dsharp32/mars_regolith_rover/Design Journal/books.jpg

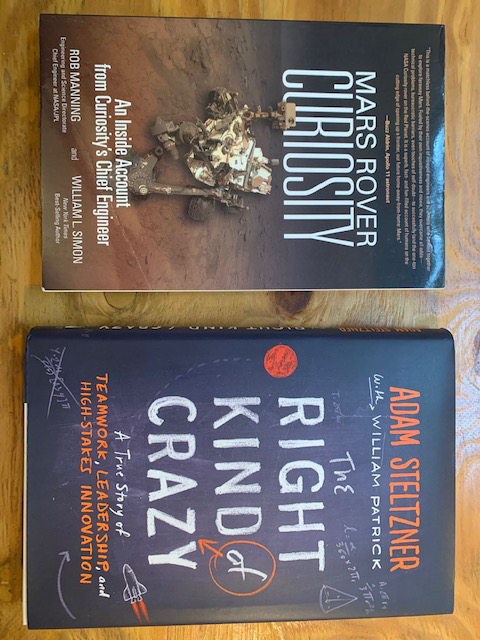
Design Journal/books.jpg
