dsharp32/mars_regolith_rover/pictures/cadc.png

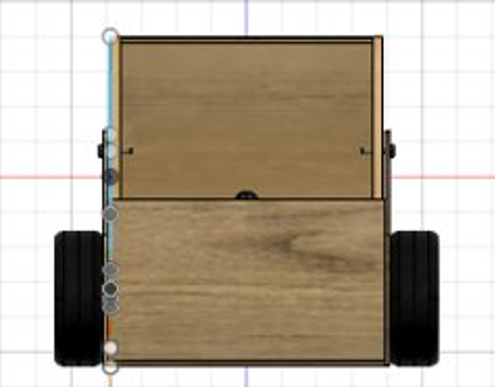
pictures/cadc.png
