dsharp32/mars_regolith_rover/Arduino Code/motor_pins.docx

// Set Right Motors to forward

//Right Back

digitalWrite(RB_in1, LOW);

digitalWrite(RB_in2, HIGH);

// set speed to 200 out of possible range 0~255

analogWrite(RB_enA, 255);

//Right Front

digitalWrite(RF_in3, HIGH);

digitalWrite(RF_in4, LOW);

// set speed to 200 out of possible range 0~255

analogWrite(RF_enB, 255);

// Set Left Motors to forward

//Left Front

digitalWrite(LF_in1, LOW);

digitalWrite(LF_in2, HIGH);

// set speed to 200 out of possible range 0~255

analogWrite(LF_enA, 255);

//Left Back

digitalWrite(LB_in3, HIGH);

digitalWrite(LB_in4, LOW);

// set speed to 200 out of possible range 0~255

analogWrite(LB_enB, 255);

delay(6000);

// Set Motors backwards

//Right Back

digitalWrite(RB_in1, HIGH);

digitalWrite(RB_in2, LOW);

// set speed to 200 out of possible range 0~255

analogWrite(RB_enA, 255);

//Right Front

digitalWrite(RF_in3, LOW);

digitalWrite(RF_in4, HIGH);

// set speed to 200 out of possible range 0~255

analogWrite(RF_enB, 255);

// Set Left Motors to forward

//Left Front

digitalWrite(LF_in1, HIGH);

digitalWrite(LF_in2, LOW);

// set speed to 200 out of possible range 0~255

analogWrite(LF_enA, 255);

//Left Back

digitalWrite(LB_in3, LOW);

digitalWrite(LB_in4, HIGH);

// set speed to 200 out of possible range 0~255

analogWrite(LB_enB, 255);
