dsharp32/mars_regolith_rover/EDP Group Presentation/ENGG1000_EDP.pptx

## Team 10 Design Presentation

## Importance of the Concept Generation Stage

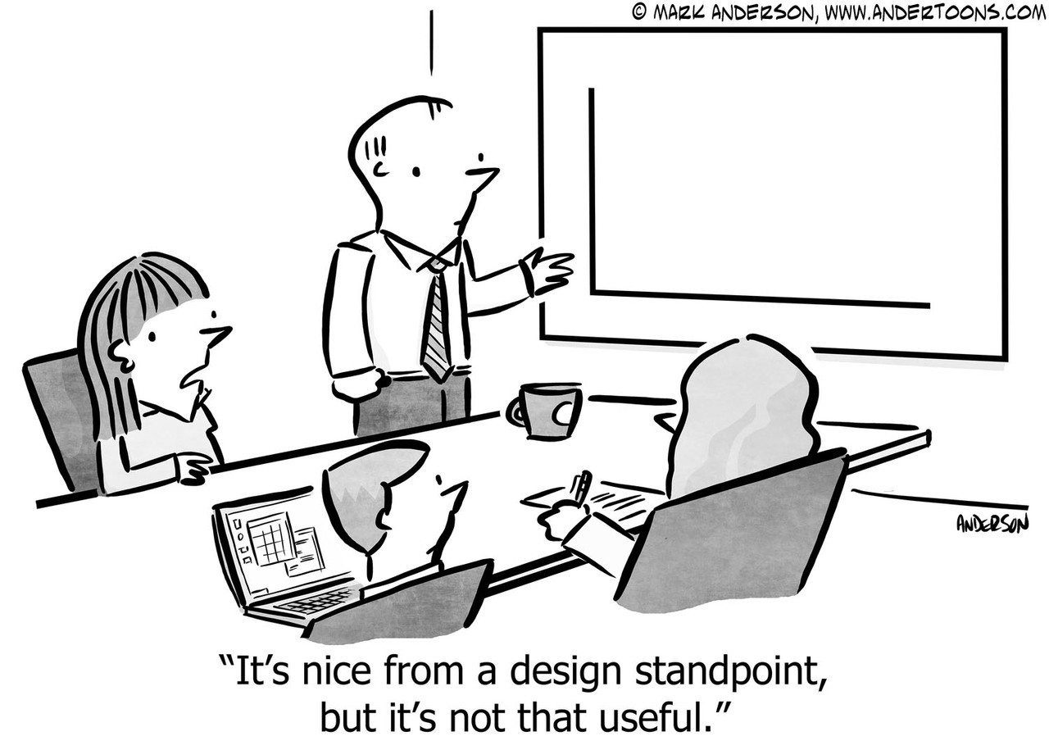
[picture p4: figure]

Notes: Every presentation should start with a joke..

Presentation schedule - problem statement, research, idea generation, morph chart, CAD design, build progress, future work and conclusion

## Project Goals

- Design and produce a rover prototype to collect regolith for 3d printing a radiation shelter.
- Required to operate in a Martian environment (think sand and rocks), no oxygen etc
- A high rate a of collection is better

- Produce a working prototype of a rover.
- The rover must be built in ten weeks.
- It must be able to move about on a Mars like surface and collect resources
- It must operate continuously and collect as much regolith as possible in 4 minutes.

Notes: Simplified problem statement - increase population of Mars!

## Slide 4

Research
- Talked to our mentor (previous champion!)
- Read books (technical and general)
- Looked at previous years designs

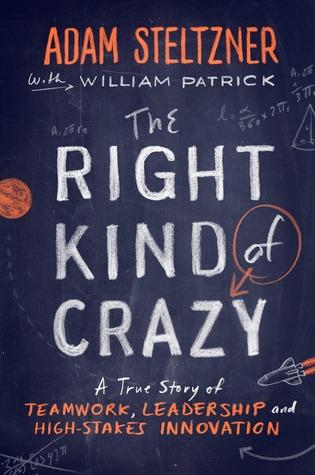
[picture p5: figure]

## Concept generation & sketches

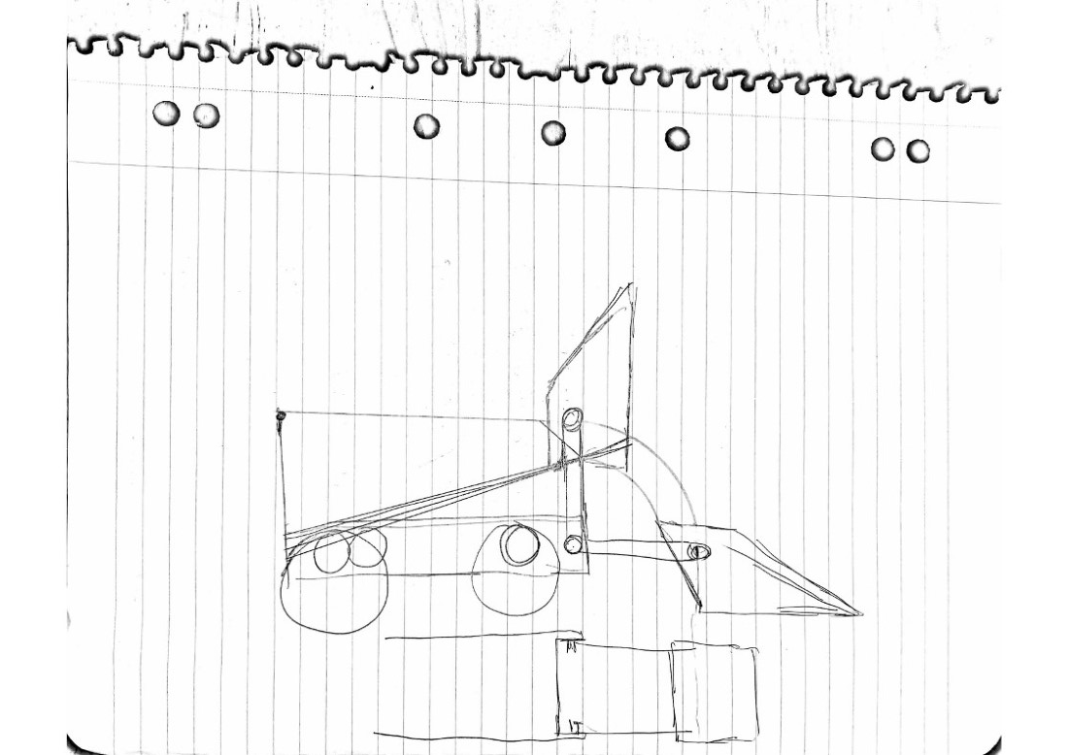
[picture p6: figure]

## Morph Chart and Analysis

- Focus on Simplicity
- Few parts - easy to take apart and maintain
- Plywood Construction
- 4 wheel drive with differential steering
- Radio controlled
- Arduino microprocessor
- Scoop for collection
- Gravity feed dispatching mechanism
- Designed to collect and carry 5kg of regolith

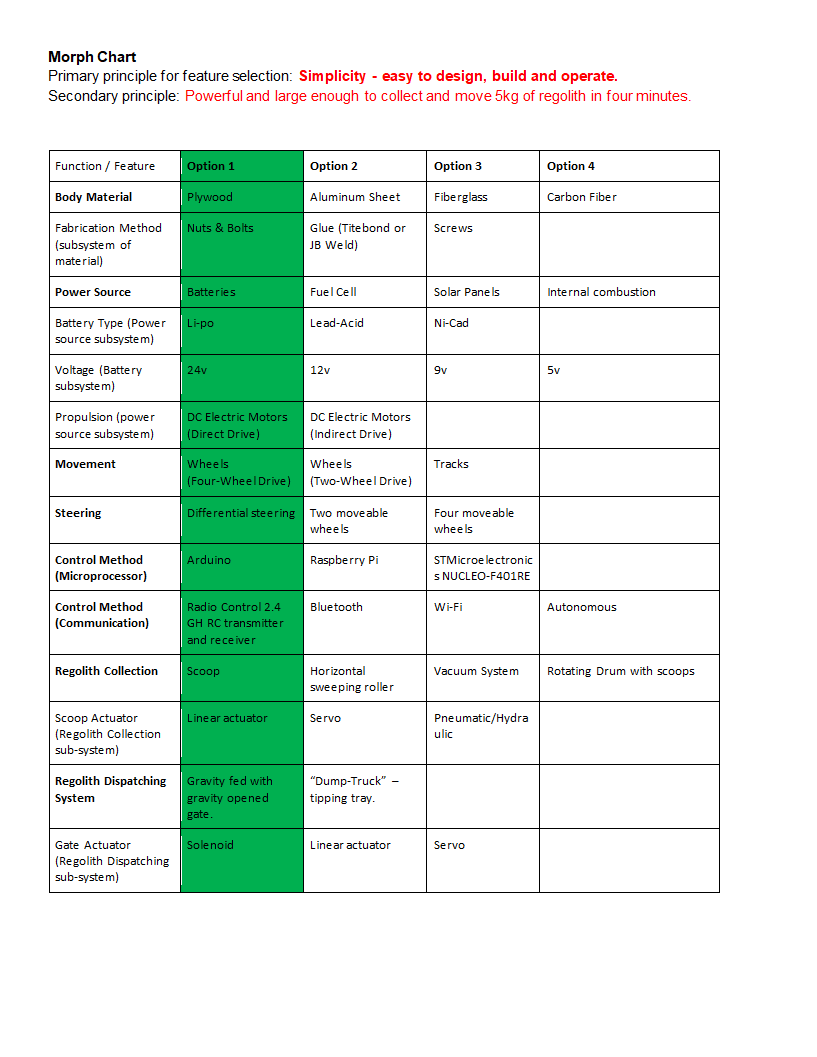
[picture p7: figure]

Notes: Simplified Morph chart - each design choice motivated by simplicity.

## CAD Design

- Designed in Fusion 360
- Profile sketches easily downloaded for laser cutting
- Made geometry of the Scoop easier to visualize and calculate
- Renders make communicating design to team and clients easier


## Slide 8

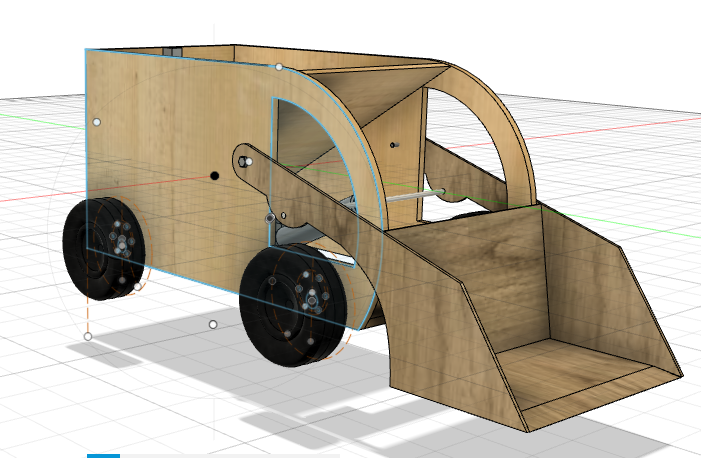
[picture p8: figure]

## Design Concept Prototype Light and strong with large capacity (5kg regolith) Powerful (24 Volt 4 wheel drive and 500N linear actuator) Easy to maintain and operate

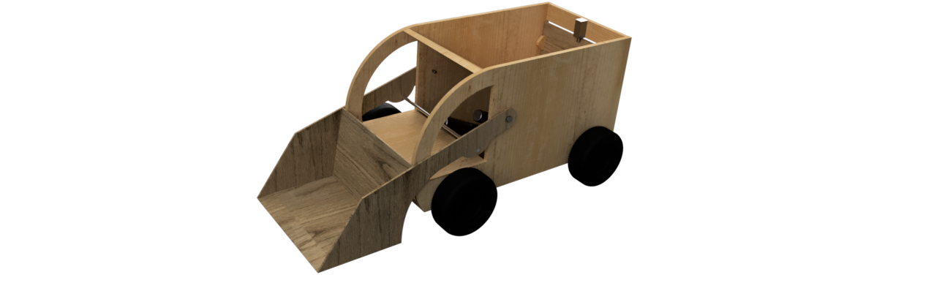
[picture p9: figure]

## Electronics & Control System

- Control system is 2.4 Gh RC transmitter and receiver
- Arduino Mega with 3x H-Bridge MOSFET Motor Controllers
- 128 bit rotary encoder for arm position
- RC servo to open dispatching gate
- Hall effect current sensor as fuse/ energy use measurement
- Code adapted from ‘Arduino Robotics’ (Warren et al. 2011)

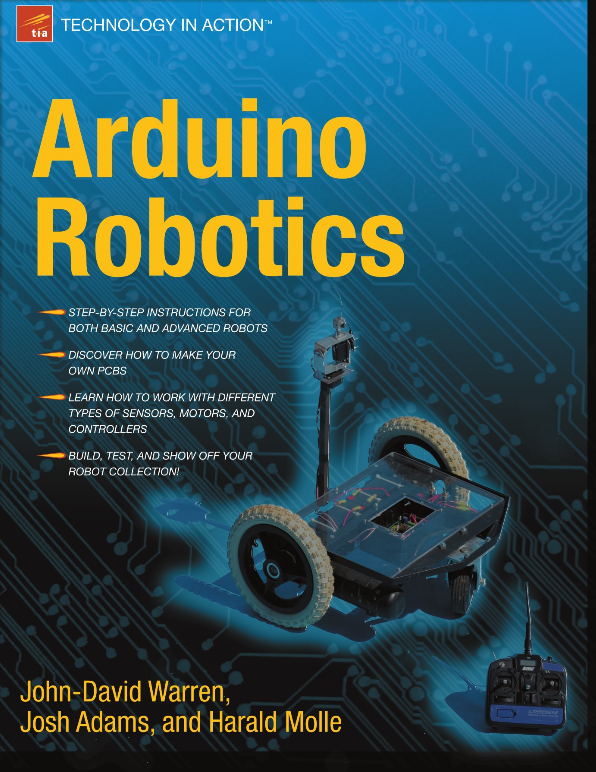
[picture p10: figure]

## Project update - April 2nd

- Body designed and assembled
- Electronics installed
- Waiting on receiver and wheel shafts
- Regolith collection and dispatch testing next week

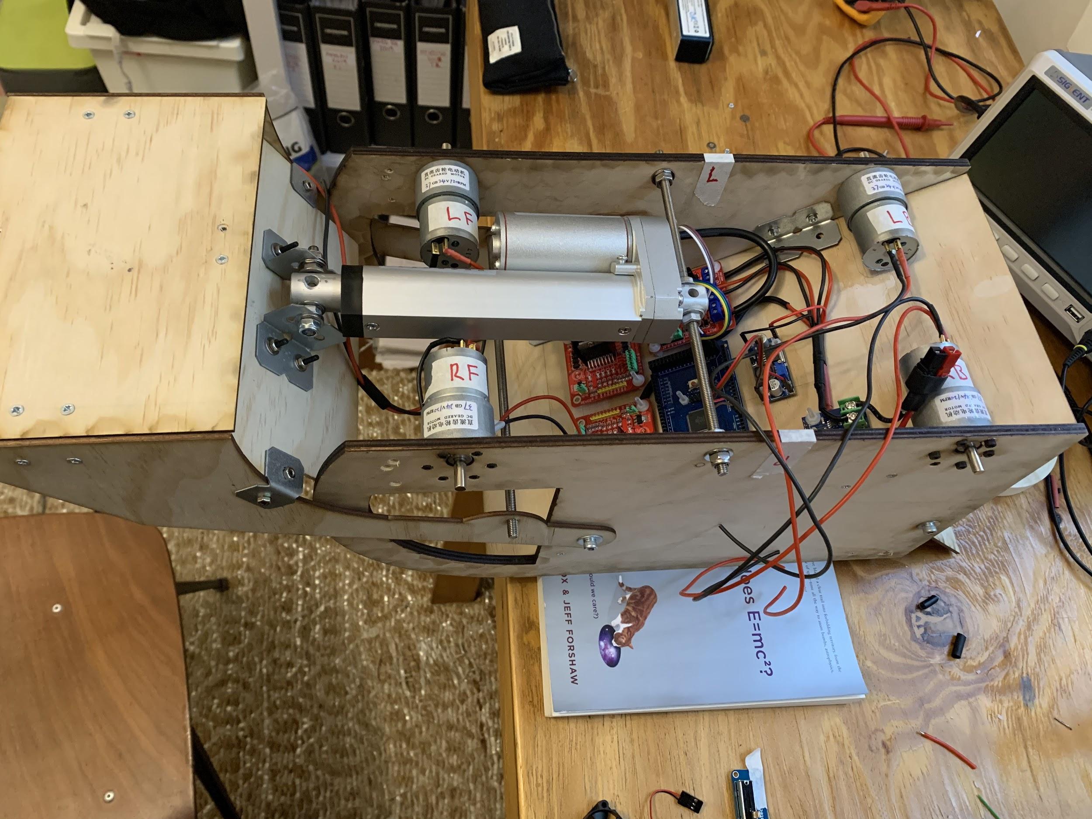
[picture p11: figure]

## Slide 12

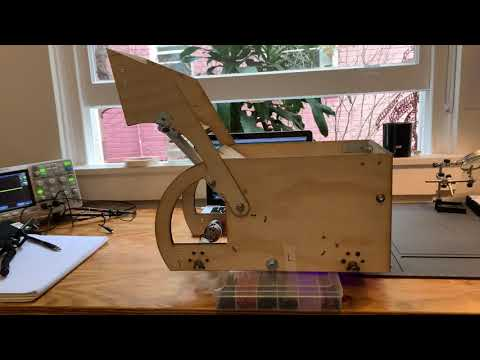
[picture p12: figure]
Regotron Scoop Test

Notes: Scoop test! Thanks for listening!
