dsharp32/mars_regolith_rover/Rover/motor_pins_rover.docx

// connect motor controller pins to Arduino digital pins

// Linear Actuator - A

int LIN_enB = 46;

int LIN_in3 = 50;

int LIN_in4 = 48;

// Left front - Motor - A

int LF_enA = 2;

int LF_in1 = 3;

int LF_in2 = 4;

// Left Back- Motor B

int LB_in3 = 5;

int LB_in4 = 6;

int LB_enB = 7;

// Right Front- Motor B

int RF_enB = 8;

int RF_in4 = 9;

int RF_in3 = 10;

// Right Back - Motor A

int RB_in2 = 11;

int RB_in1 = 12;

int RB_enA = 13;
