dsharp32/mars_regolith_rover/Rover/Rover_Arduino_MOTOR_PINS.docx

// connect motor controller pins to Arduino digital pins

// Linear Actuator

int LIN_enA = 39;

int LIN_in1 = 37;

int LIN_in2 = 35;

// Right Back - Motor A

int RB_enA = 22;

int RB_in1 = 24;

int RB_in2 = 26;

// Right Front- Motor B

int RF_enB = 32;

int RF_in3 = 28;

int RF_in4 = 30;

// Left Back - Motor B

int LB_enA = 33;

int LB_in1 = 31;

int LB_in2 = 29;

// Left Front- Motor A

int LF_enB = 23;

int LF_in3 = 27;

int LF_in4 = 25;
