dsharp32/mars_regolith_rover/Rover/serial_plotter_code.docx

int analogPin = A0; // linear Hall analog interface

int analogVal; // analog readings

void setup ()

{

pinMode(analogPin, INPUT);

Serial.begin(9600);

}

void loop ()

{

// Read the analog interface

analogVal = analogRead(analogPin);

Serial.println(analogVal); // print analog value

delay(100);

}
