dsharp32/mars_regolith_rover/Rover/Team Assessment.docx

Team Assessment

Explain why concept generation is important.

Create Morph chart – make sketches

Discuss ideas in group.

Put in where we are currently at in design/build
