dsharp32/mars_regolith_rover/Rover/BTS7960_Schematic.docx

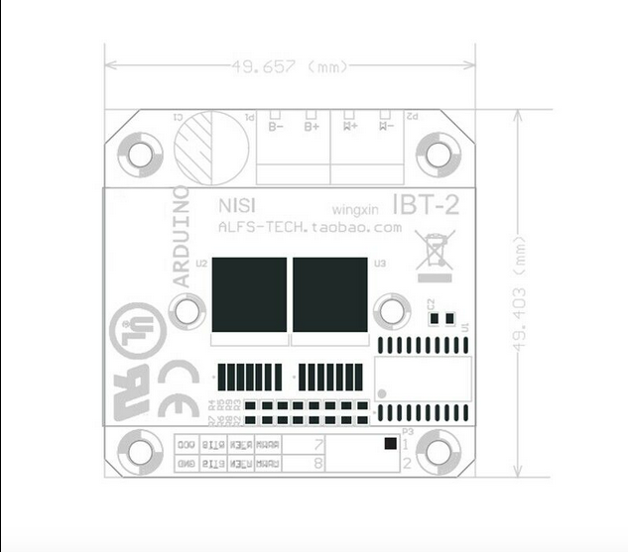
[picture p43: figure]
