dsharp32/mars_regolith_rover/Rover/Books.docx

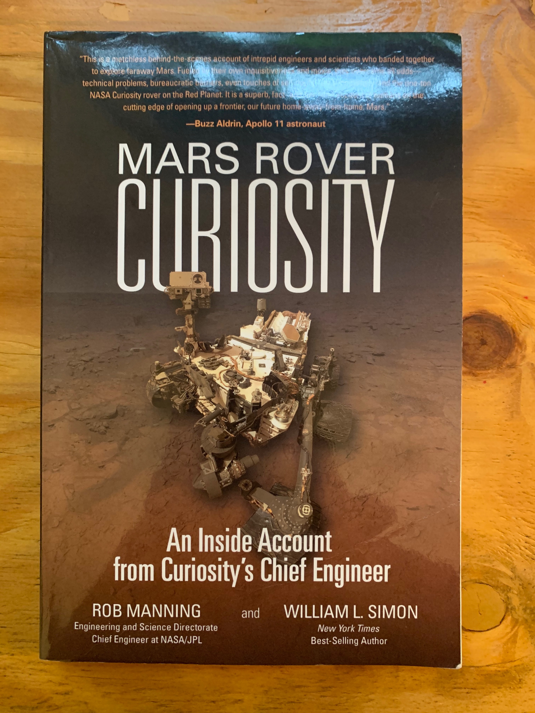
[picture p44: figure]
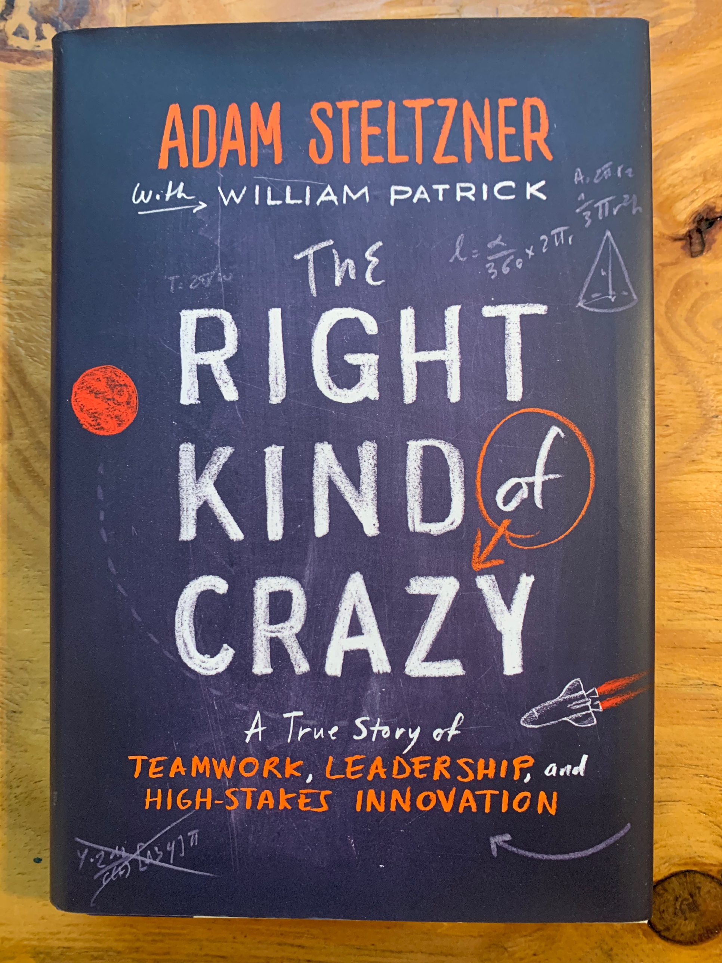
[picture p45: figure]
