dsharp32/mars_regolith_rover/Testing/rover_specifications.xlsx

Dimensions | Length [cm] | Width [cm] | Height[cm]
Scoop Lowered | 55 | 27.5 | 23
Scoop Raised | 47 | 27.5 | 40
Weight [kg] | 4.3
Maximum Load [kg] | 5.8
Maximum Speed [km/h] | 1.94
Collection Rate [kg/h] | 32.5
Energy Use [Wh] | 41.8
