dsharp32/mars_regolith_rover/pictures/cada.jpg

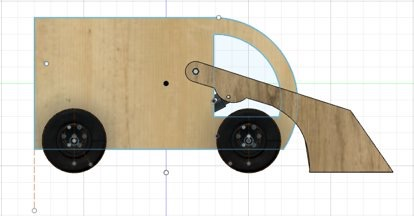
pictures/cada.jpg
