dsharp32/mars_regolith_rover/pictures/cadb.jpg

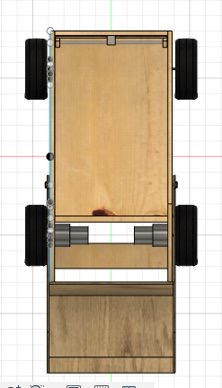
pictures/cadb.jpg
