dsharp32/mars_regolith_rover/pictures/Picture 1.jpg

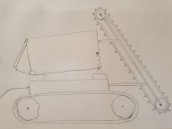
pictures/Picture 1.jpg
