dsharp32/mars_regolith_rover/pictures/Picture 2.jpg

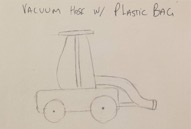
pictures/Picture 2.jpg
