dsharp32/mars_regolith_rover/pictures/Picture 3.png

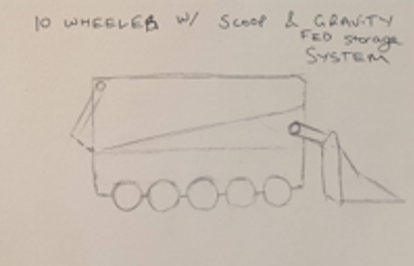
pictures/Picture 3.png
