dsharp32/mars_regolith_rover/pictures/Picture 4.png

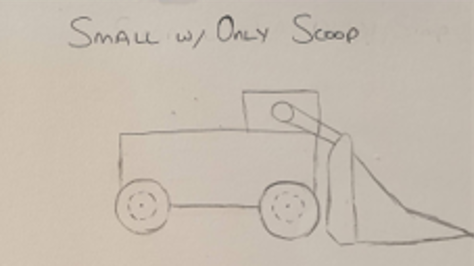
pictures/Picture 4.png
