dsharp32/mars_regolith_rover/pictures/Picture 5.png

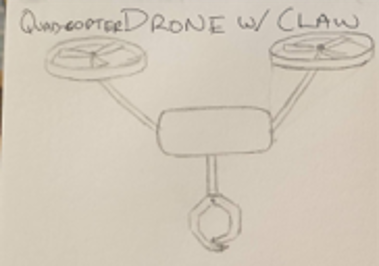
pictures/Picture 5.png
