dsharp32/mars_regolith_rover/Rover/Draft_V2_2020-Mar-19_04-42-36AM-000_CustomizedView4141925993_png_alpha.png

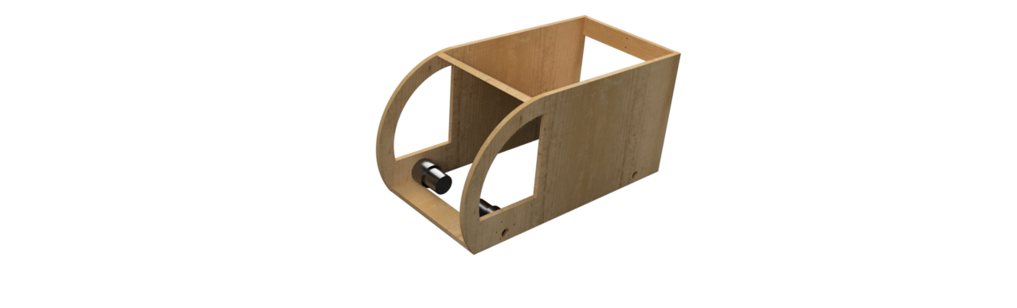
Rover/Draft_V2_2020-Mar-19_04-42-36AM-000_CustomizedView4141925993_png_alpha.png
