dsharp32/mars_regolith_rover/Rover/DRe8PbEWkAApa1v.jpg

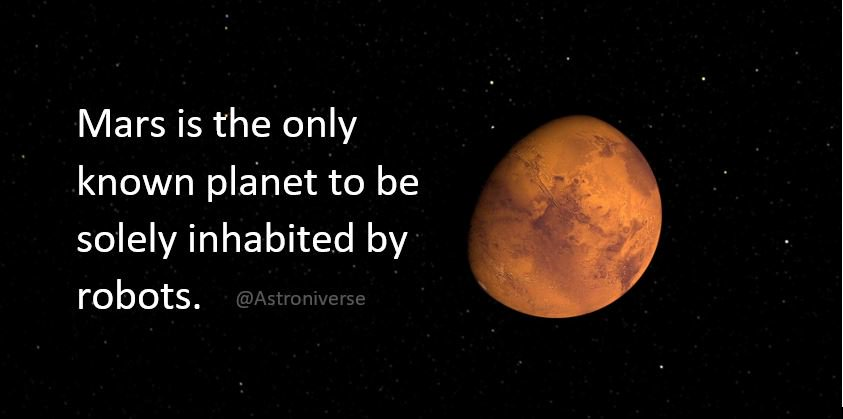
Rover/DRe8PbEWkAApa1v.jpg
