dsharp32/mars_regolith_rover/Rover/IMG_1760.jpg

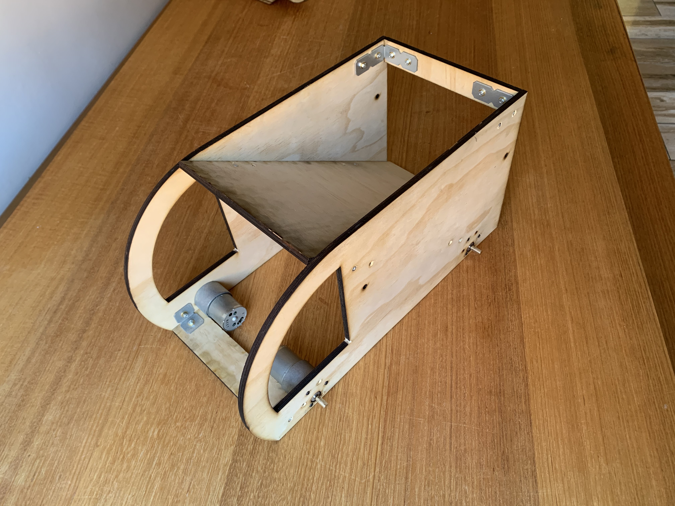
Rover/IMG_1760.jpg
