dsharp32/mars_regolith_rover/Rover/IMG_1822.jpg

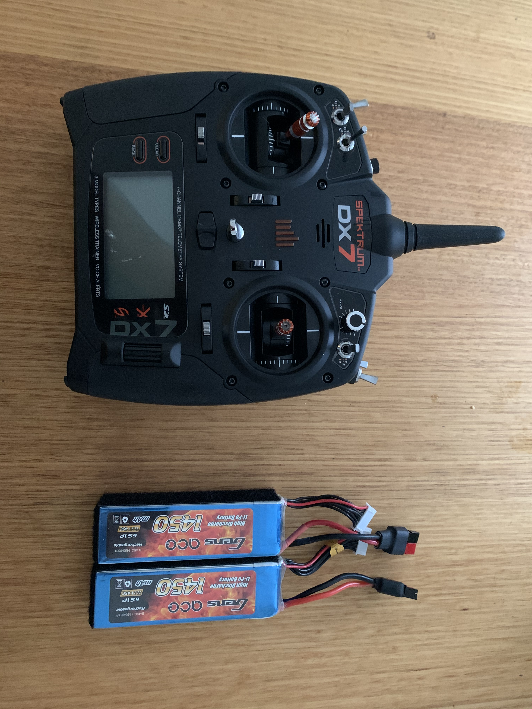
Rover/IMG_1822.jpg
