dsharp32/mars_regolith_rover/Rover/Rover_Presentation_Draft_V2_2020-Mar-19_03-32-50AM-000_CustomizedView21052464668_png.png

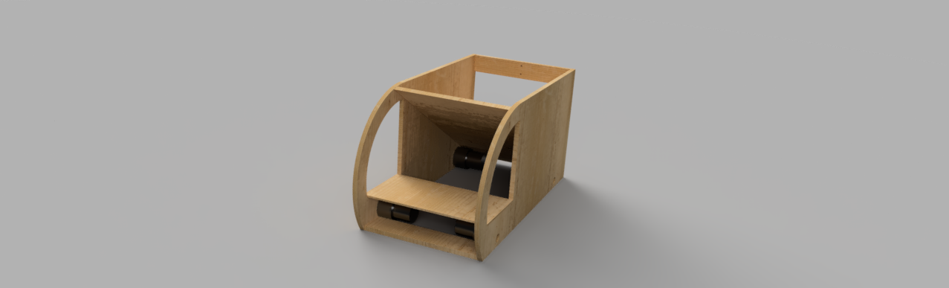
Rover/Rover_Presentation_Draft_V2_2020-Mar-19_03-32-50AM-000_CustomizedView21052464668_png.png
