dsharp32/mars_regolith_rover/Rover/s-l500.jpg

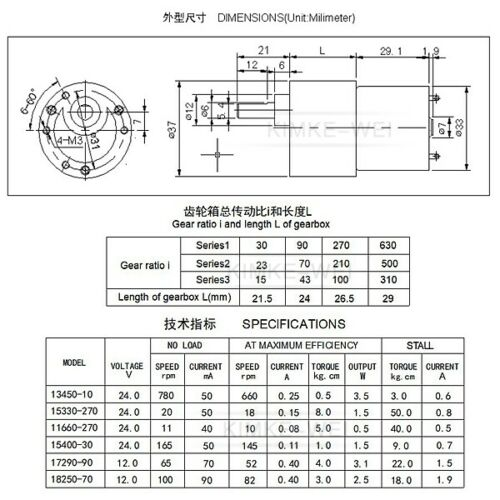
Rover/s-l500.jpg
