dsharp32/mars_regolith_rover/Rover/Screen Shot 2020-03-12 at 12.49.16 am.png

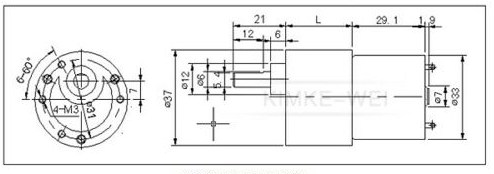
Rover/Screen Shot 2020-03-12 at 12.49.16 am.png
