dsharp32/mars_regolith_rover/Rover/View recent photos.png

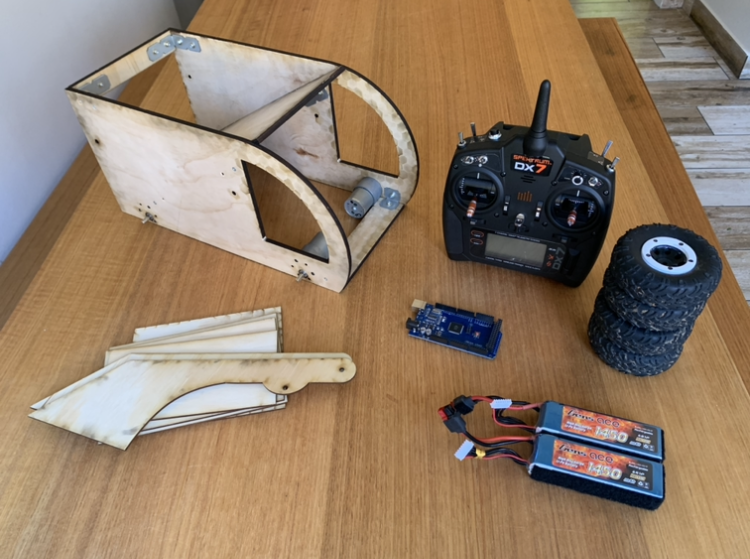
Rover/View recent photos.png
