dsharp32/mars_regolith_rover/Purchasing List/Purchasing_list.xlsx

Component List
No | Description | Required Quantity | Vendor | Purchase Quantity | Unit Price | Price | Website link
Main Components
1 | Interior Plywood Sheet 897mm*600mm*7mm | 1 | Bunnings | 1 | $14.00 | $14.00
2 | Interior Plywood Sheet 1200mm*810mm*3mm | 1 | Bunnings | 1 | $29.00 | $29.00
3 | Threaded Stainless Steel Rod 1200mm*6mm | 1 | Bunnings | 1 | $7.70 | $7.70
4 | Angle Bracket 25mm*25mm*40mm | 3 | Bunnings | 3 | $4.60 | $13.80
5 | M5*35mm Machine Bolt | 3 | Bunnings | 3 | $3.35 | $10.05
6 | M5 Flat Washer 35Pk | 1 | Bunnings | 2 | $4.60 | $9.20
7 | M5 Hexagon Nut 20Pk | 1 | Bunnings | 3 | $3.35 | $10.05
8 | M6 Nylon Lock Nut 6pk | 2 | Bunnings | 2 | $3.35 | $6.70
9 | M6 Nylon Stainless Steel Nut 6pk | 2 | Bunnings | 2 | $3.35 | $6.70
10 | M3*15 mm Machine Bolt | 3 | Bunnings | 3 | $3.35 | $10.05
11 | M3 Flat Washer 35Pk | 1 | Bunnings | 2 | $4.60 | $9.20
12 | M3 Hexagon Nut 200Pk | 1 | Jaycar | 1 | $9.95 | $9.95
13 | Threaded Stainless Steel Rod 1200mm*8mm | 1 | Bunnings | 1 | $7.70 | $7.70
14 | Coreflute | 1 | Bunnings | 1
15
Electronic Components
16 | MEGA 2560 R3 Arduino komp. Mikrokontroller Board Atmel ATmega2560 CH340G | 1 | eBay | 1 | 19.50 | 19.50
17 | 37mm 12V/24V DC 5RPM - 1000RPM High Torque Gear Box Motor Reducer Reversible New | 4 | eBay | 4 | 19.69 | 78.76
18 | Module DC-DC Volt Regulator Arduino Comp | 1 | Jaycar | 1 | 7.95 | 7.95
19 | DC12/24V 20mm-500mm Multi-function Linear Actuator Motor Stroke Heavy Duty xN | 1 | eBay | 1 | 57.58 | 57.58
20 | Spektrum AR6210 2.4G 6CH Receiver | 1 | Secondhand | 1 | 40.00 | 40.00
21 | Arduino Compatible Stepper Motor Controller Module | 3 | Jaycar | 3 | 14.95 | 44.85
22 | Arduino Compatible 5A Current Sensor Module | 1 | Jaycar | 1 | 9.95 | 9.95
23 | Hookup wire
24 | Mini Brass Spade Connector 100Pk | 1 | Jaycar | 1 | $11.95 | $11.95
25
26
27
 |  |  |  |  | Total: | 414.64 | AUD
Other Potential Components/Tools
33
34
35
36
37
40
