dsharp32/mars_regolith_rover/Rover/Main_Body_Rover.dxf

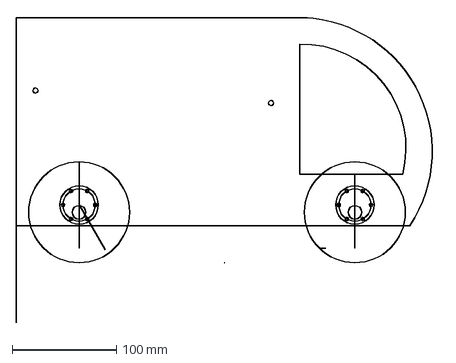
[picture p62: CAD file, 2020-05-26]
Rover/Main_Body_Rover.dxf
407.2 x 294.6 mm
