dsharp32/mars_regolith_rover/Rover/Rear_Gate_Rover.dxf

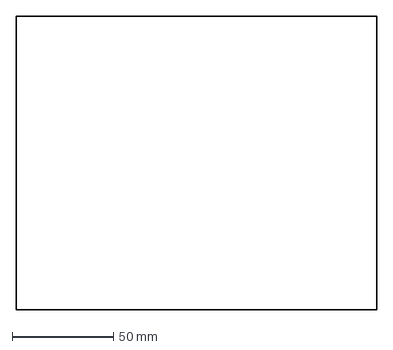
[picture p63: CAD file, 2020-05-26]
Rover/Rear_Gate_Rover.dxf
178.0 x 145.0 mm
