dsharp32/mars_regolith_rover/Rover/Front_Brace_Rover.dxf

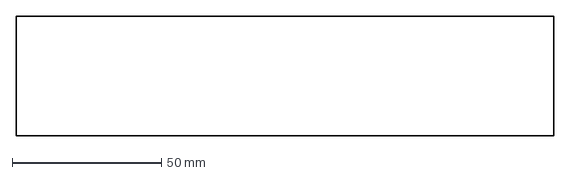
[picture p64: CAD file, 2020-05-26]
Rover/Front_Brace_Rover.dxf
180.0 x 40.0 mm
