dsharp32/mars_regolith_rover/Rover/Scoop_Floor_Rover.dxf

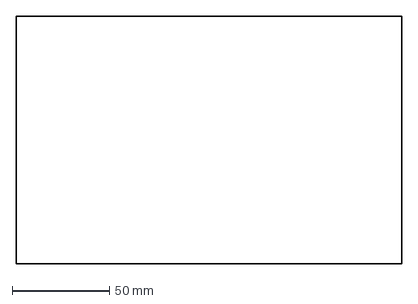
[picture p65: CAD file, 2020-05-26]
Rover/Scoop_Floor_Rover.dxf
198.0 x 127.0 mm
