dsharp32/mars_regolith_rover/Rover/Solenoid_Support_Rover.dxf

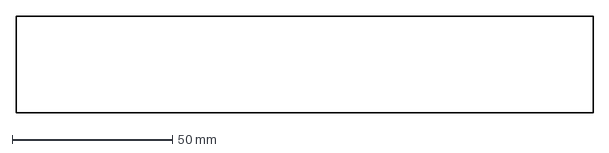
[picture p66: CAD file, 2020-05-26]
Rover/Solenoid_Support_Rover.dxf
180.0 x 30.0 mm
