dsharp32/mars_regolith_rover/Rover/Regolith_Tray_Rover.dxf

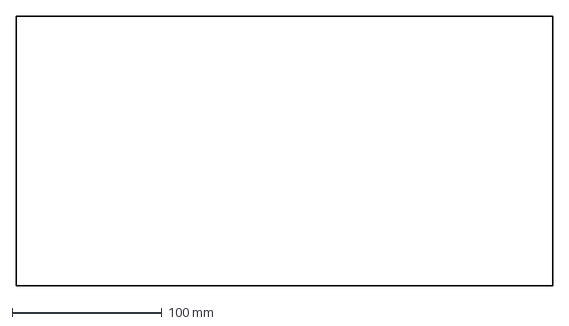
[picture p67: CAD file, 2020-05-26]
Rover/Regolith_Tray_Rover.dxf
358.0 x 180.0 mm
