dsharp32/mars_regolith_rover/Rover/Scoop_Rover.dxf

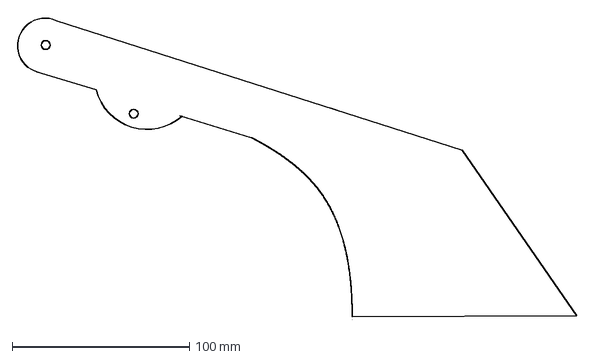
[picture p68: CAD file, 2020-05-26]
Rover/Scoop_Rover.dxf
316.5 x 171.2 mm
