dsharp32/mars_regolith_rover/Rover/Scoop_Back_Rover.dxf

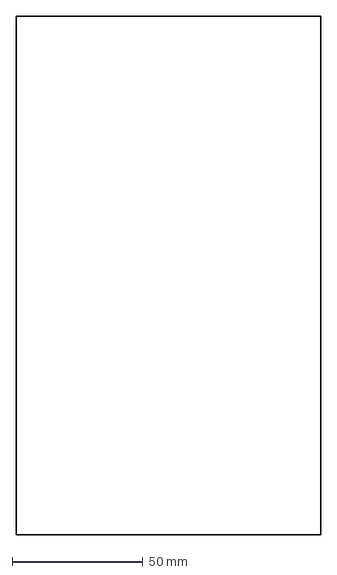
[picture p69: CAD file, 2020-05-26]
Rover/Scoop_Back_Rover.dxf
116.5 x 198.0 mm
