dsharp32/mars_regolith_rover/Rover/Arduino_Tray_Rover.dxf

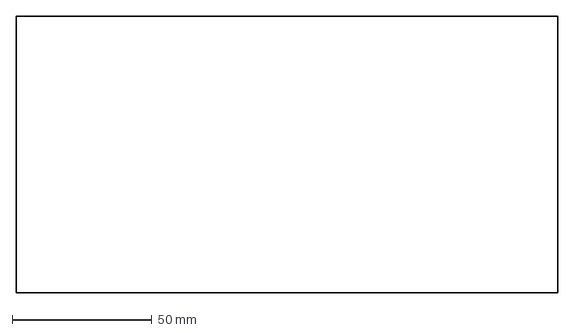
[picture p70: CAD file, 2020-05-26]
Rover/Arduino_Tray_Rover.dxf
193.7 x 99.0 mm
