dsharp32/mars_regolith_rover/Rover/Mechanical Build March 16th – 20th.pdf

# Mechanical Build March 16th – 20th

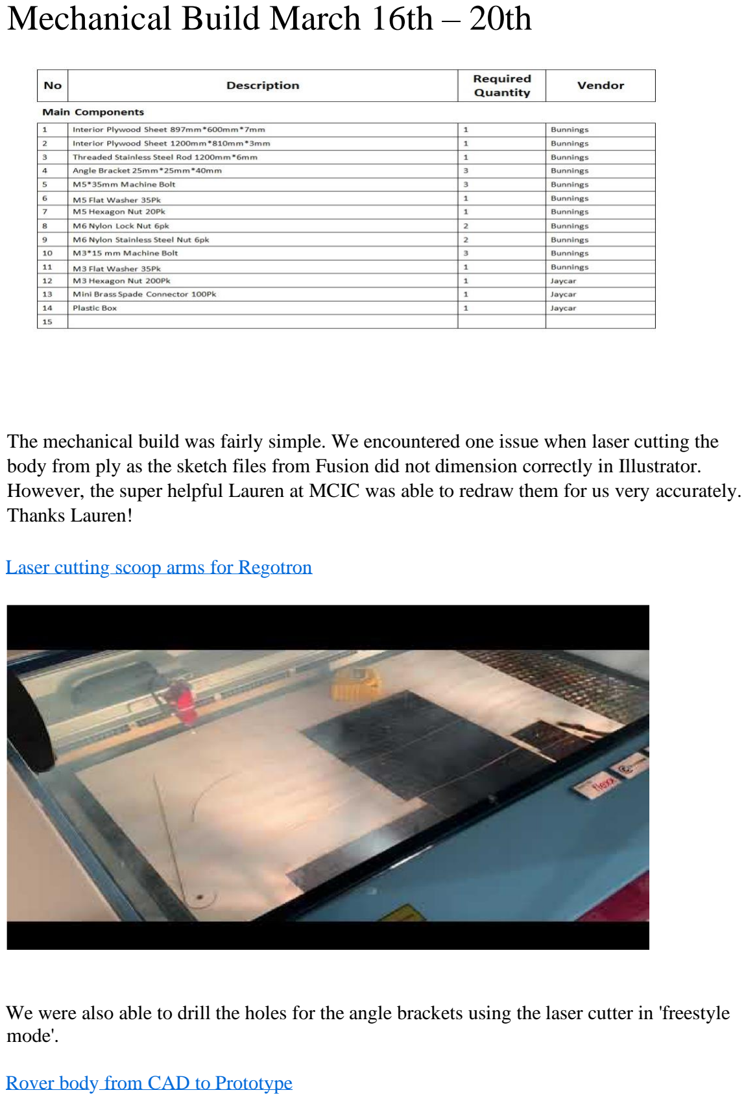
[picture p71: page 1]

The mechanical build was fairly simple. We encountered one issue when laser cutting the body from ply as the sketch files from Fusion did not dimension correctly in Illustrator. However, the super helpful Lauren at MCIC was able to redraw them for us very accurately. Thanks Lauren!

Laser cuttin (https://youtu.be/MvdhVEoitDo)g (https://youtu.be/MvdhVEoitDo) scoop arms for Re (https://youtu.be/MvdhVEoitDo)g (https://youtu.be/MvdhVEoitDo)otron (https://youtu.be/MvdhVEoitDo)

We were also able to drill the holes for the angle brackets using the laser cutter in 'freestyle mode'.

Rover bod (https://youtu.be/zkt2rj4I97I)y (https://youtu.be/zkt2rj4I97I) from CAD to Prototype (https://youtu.be/zkt2rj4I97I)

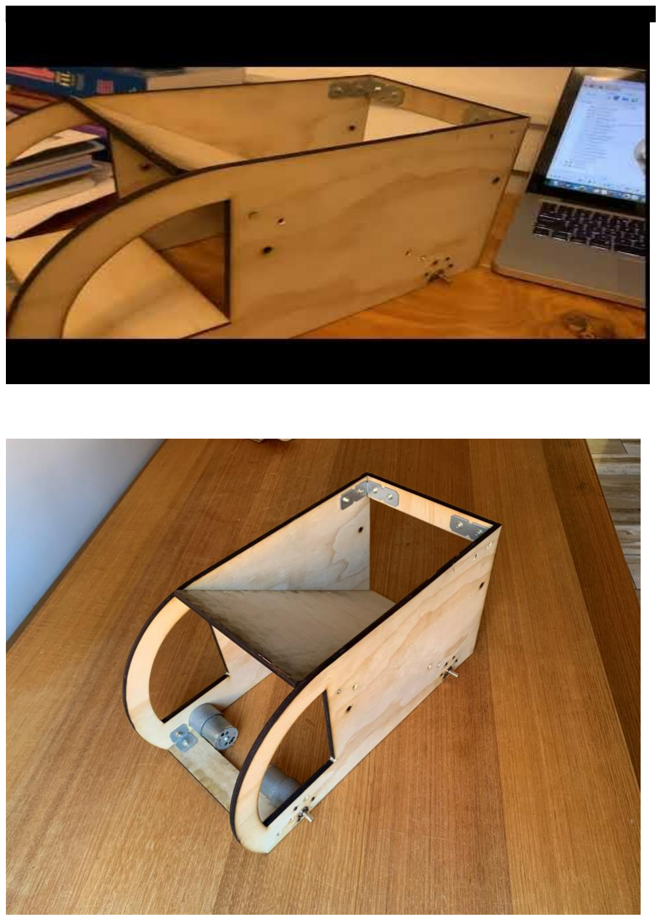
[picture p72: page 2]
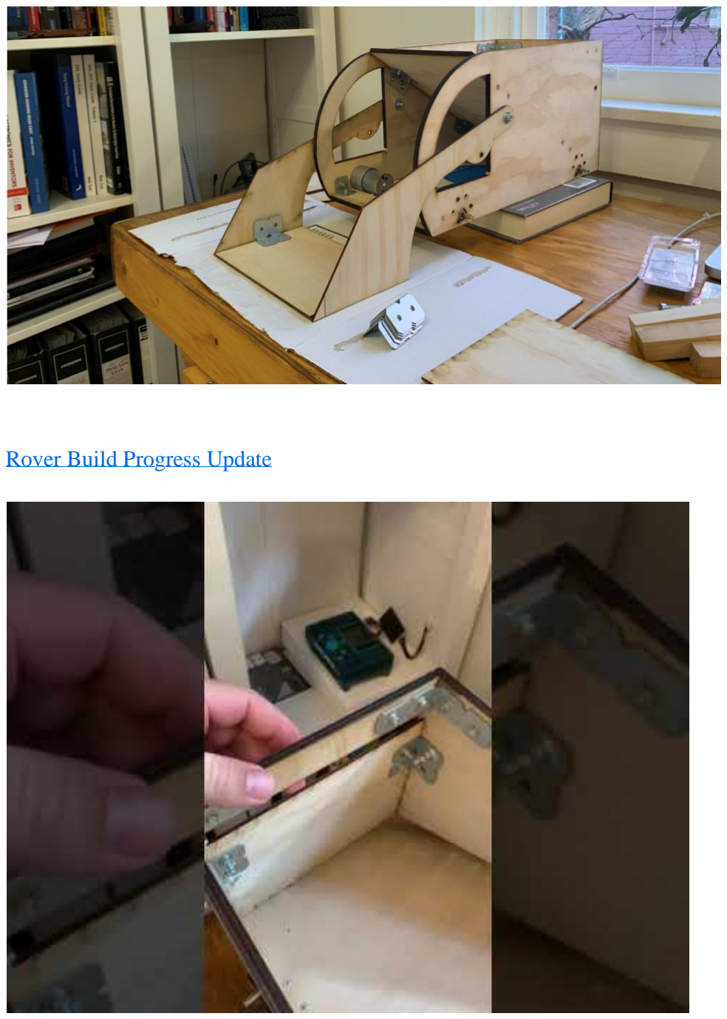
[picture p73: page 3]

Rover Build Pro (https://youtu.be/pcVCasUEwuk)g (https://youtu.be/pcVCasUEwuk)ress Update (https://youtu.be/pcVCasUEwuk)
