dsharp32/mars_regolith_rover/Testing/regolith_collection_test.xlsx

Test One
Date: 20/4/20 | Time (s) | Regolith Collected (g) | Energy Use (mAh)
Battery One | 240 | 2155.7 | 113.00
Test Two
Date: 20/4/20 | Time (s) | Regolith Collected (g) | Energy Use (mAh)
Battery Two | 240 | 2177 | 109.00
