dsharp32/mars_regolith_rover/Testing/speed_test.xlsx

Test One (Empty)
Battery No. | run 1 | run 2 | run 3 | run 4 | run 5
Time 1(s):
Time 2(s):
Run Distance (m) | 5 | 5 | 5 | 5 | 5
Total distance (m) | 10 | 10 | 10 | 10 | 10
Test Two (1 kg load)
Battery No. | run 1 | run 2 | run 3 | run 4 | run 5
Time 1(s):
Time 2(s):
Run Distance (m) | 5 | 5 | 5 | 5 | 5
Total distance (m) | 10 | 10 | 10 | 10 | 10
