dsharp32/mars_regolith_rover/Testing/rover_speed_test.xlsx

Test One (Empty)
Date: | run 1 | run 2 | run 3 | run 4 | run 5
Time 1(s): | 9.48 | 9.63 | 9.88 | 9.44 | 9.76
Time 2(s): | 9.01 | 8.74 | 8.53 | 8.39 | 8.86
Run Distance (m) | 5 | 5 | 5 | 5 | 5
Total distance (m) | 10 | 10 | 10 | 10 | 10
mAh: | 73
Test Two (1 kg load)
Date: | run 1 | run 2 | run 3 | run 4 | run 5
Time 1(s): | 9.71 | 9.66 | 10.16 | 10.06 | 9.80
Time 2(s): | 8.55 | 8.72 | 8.75 | 8.63 | 8.75
Run Distance (m) | 5 | 5 | 5 | 5 | 5
Total distance (m) | 10 | 10 | 10 | 10 | 10
mAh: | 69
run 1 | run 2 | run 3 | run 4 | run 5 | m/s | k/h
9.48 | 9.63 | 9.88 | 9.44 | 9.76 | 48.19
9.01 | 8.74 | 8.53 | 8.39 | 8.86 | 43.53
5 | 5 | 5 | 5 | 5 | 91.72 | 0.03
10 | 10 | 10 | 10 | 10 | 50.00 | 0.05
73 |  |  |  |  | 0.55 | 1.96
run 1 | run 2 | run 3 | run 4 | run 5 | m/s | k/h
9.71 | 9.66 | 10.16 | 10.06 | 9.80 | 49.39
8.55 | 8.72 | 8.75 | 8.63 | 8.75 | 43.40
5 | 5 | 5 | 5 | 5 | 92.79 | 0.03
10 | 10 | 10 | 10 | 10 | 50.00 | 0.05
 |  |  |  |  | 0.54 | 1.94
