dsharp32/mars_regolith_rover/Design Journal/Angle_calcs.pdf

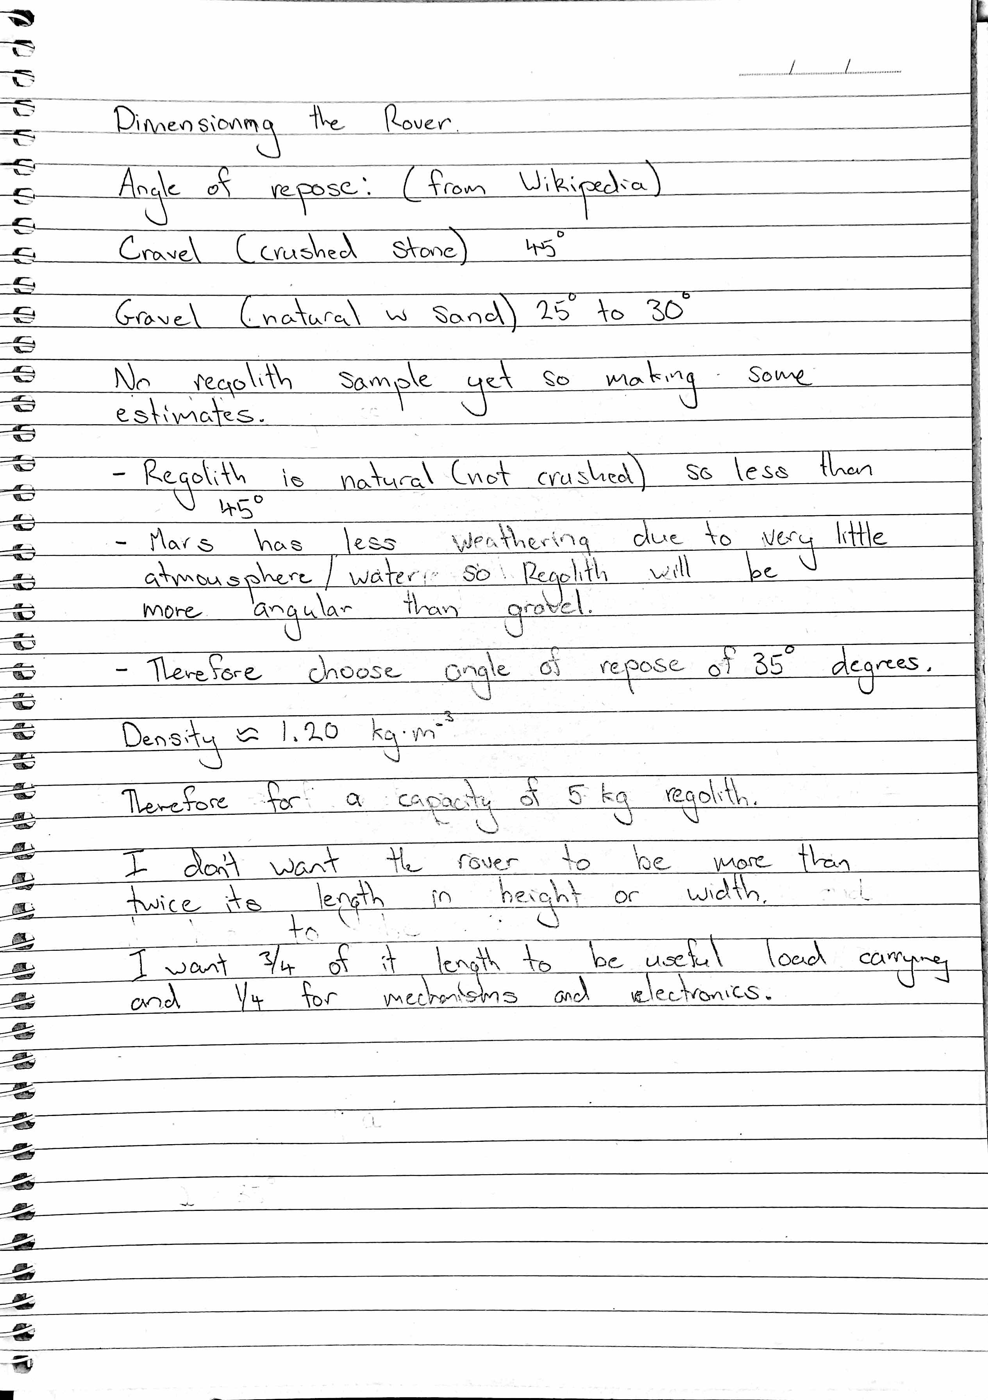
[picture p102: page 1]
