dsharp32/mars_regolith_rover/Design Journal/Rover_V2.png

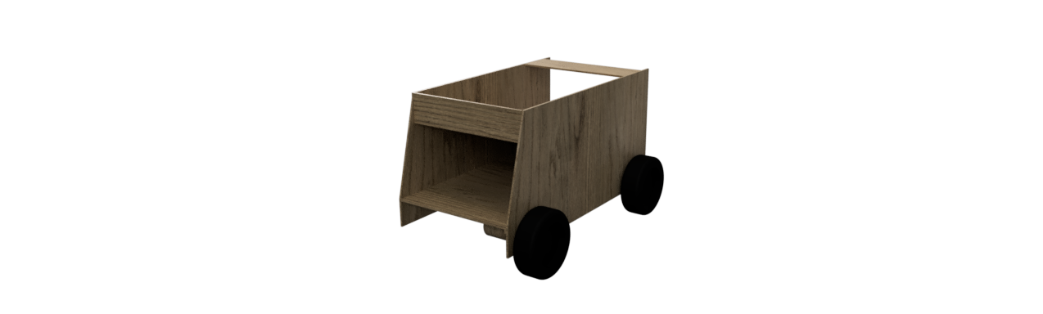
Design Journal/Rover_V2.png
