dsharp32/mars_regolith_rover/Design Journal/Rover_V3.png

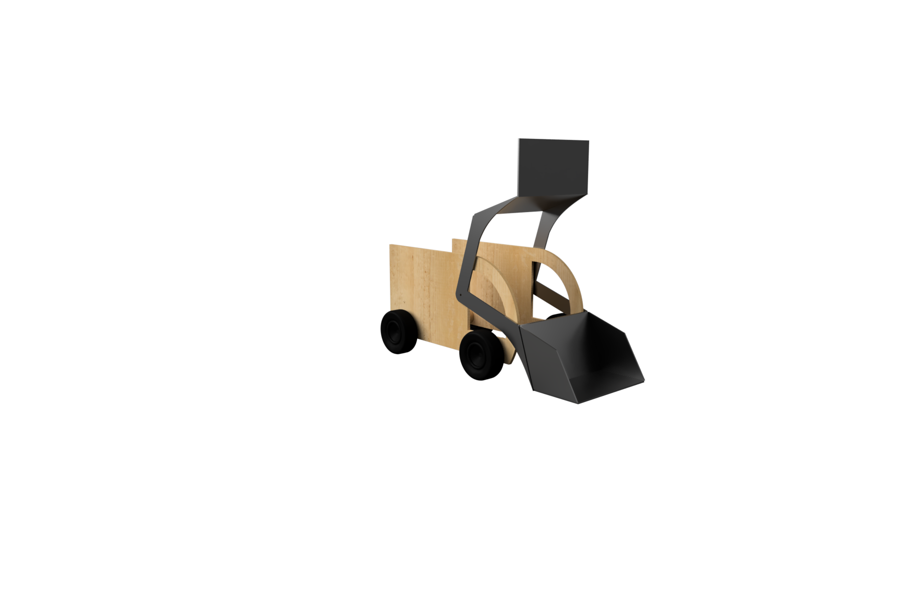
Design Journal/Rover_V3.png
