dsharp32/mars_regolith_rover/Design Journal/Sketches.jpg

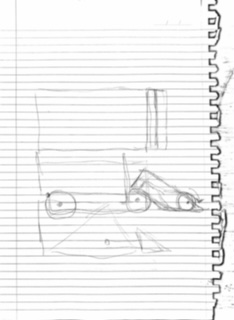
Design Journal/Sketches.jpg
