dsharp32/mars_regolith_rover/Rover/IMG_1820.jpg

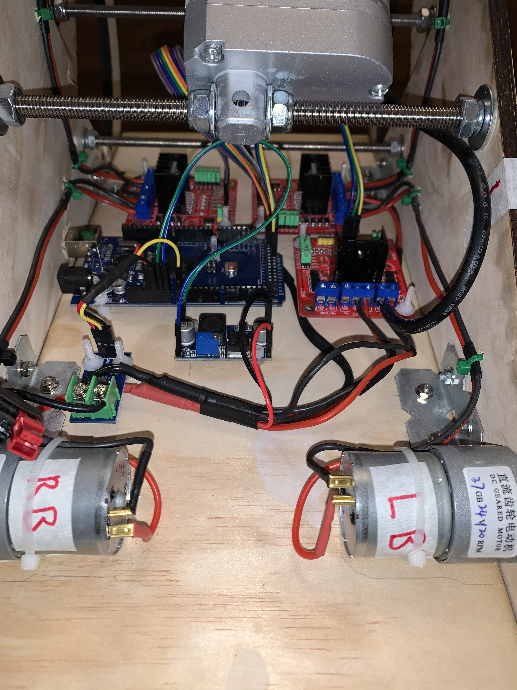
Rover/IMG_1820.jpg
